jaymzmnrd/myoelectric-prosthetic-hand/hardware/design/Parts flat lay on cutting mat.jpg

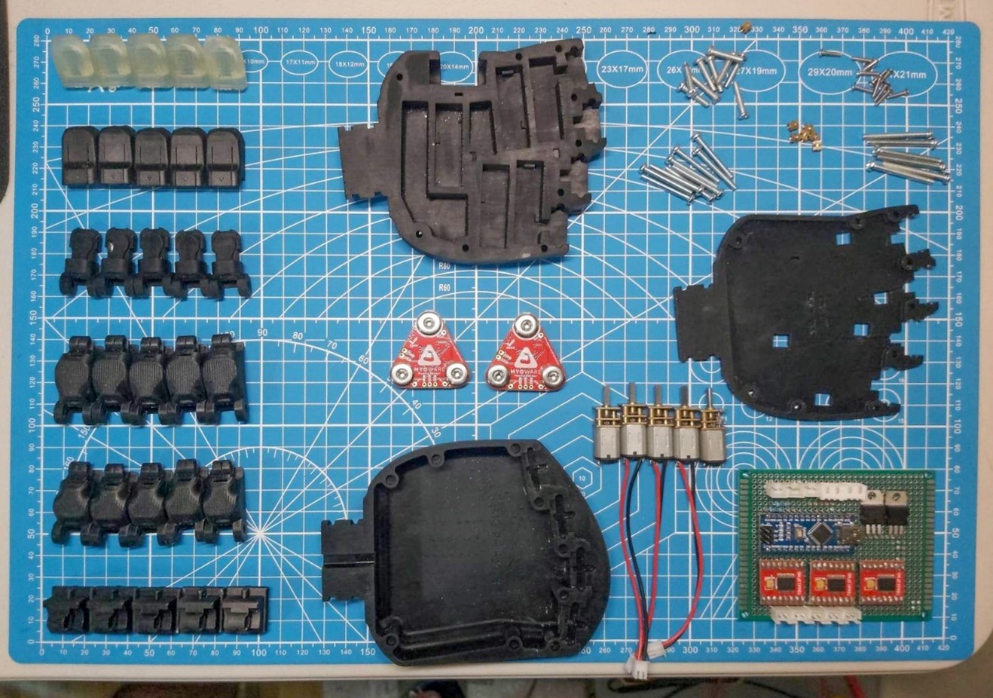
hardware/design/Parts flat lay on cutting mat.jpg
