jaymzmnrd/myoelectric-prosthetic-hand/hardware/design/Post processed sleeve with velcro strap attached.jpg

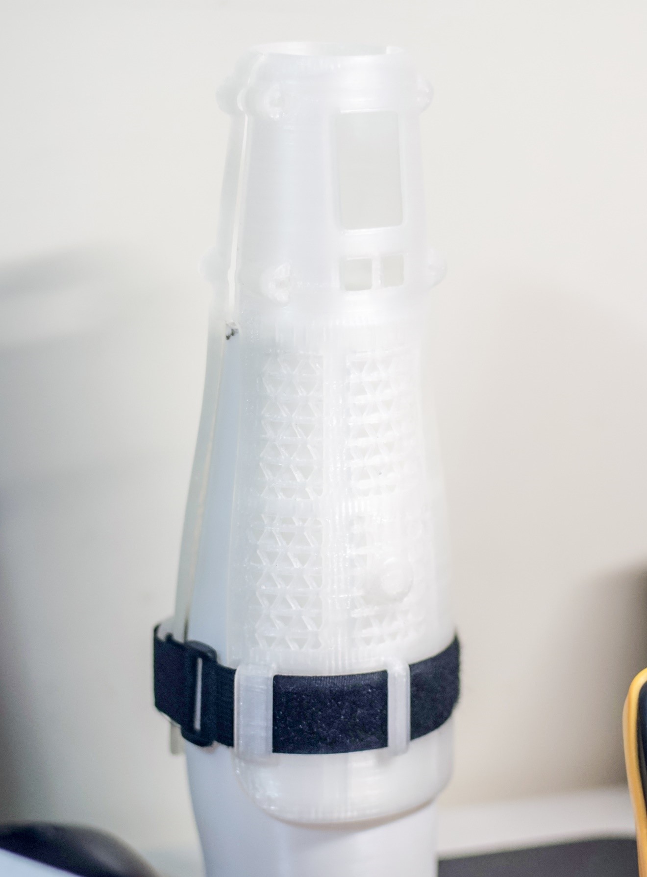
hardware/design/Post processed sleeve with velcro strap attached.jpg
