jaymzmnrd/myoelectric-prosthetic-hand/docs/README.md

## Cost

One of the project targets was to create an affordable prosthetic hand for amputees. The total cost of the device is 24,513 pesos. The prosthetic hand uses two (2) MyoWare sensors which is 21.21% of the total cost.

## Schematic Diagram

**Schematic diagram of the device**

overall-schematic

**Wiring diagram of power supply**

power-supply-diagram

## Software Specifications

- Visual Studio Code (Python)
- Arduino IDE 
- Fritzing
- Onshape

## Hardware Specifications
- MyoWare 2.0 Muscle Sensor
- Arduino Nano
- Sparkfun Motor Drivers
- Force-Sensitive Resistor
- DC Motor
- Vibration Motor
- PKCell 21700 Battery 3.7v
- Kevlar String
- Voltage Regulator 
- Resistor
- NPN Transistor
- Battery Capacity Indicator
- Charging Module
- Push Button Switch
- Step-Up Module
- Microswitch Pushbutton
- USB Type-C Female Connector
- Brass Rod
- Torsion Springs
- Round Head Screw
