jaymzmnrd/myoelectric-prosthetic-hand/hardware/circuit-schematics/overall-schematic.png

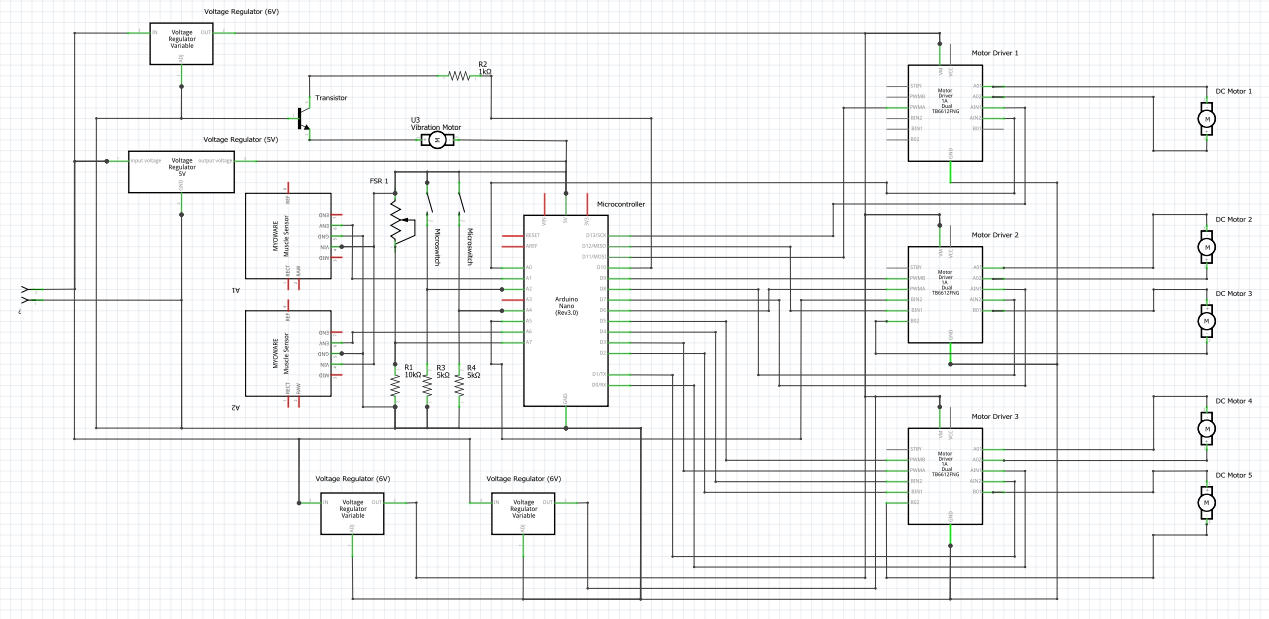
hardware/circuit-schematics/overall-schematic.png
