jaymzmnrd/myoelectric-prosthetic-hand/hardware/circuit-schematics/power-supply-diagram.PNG

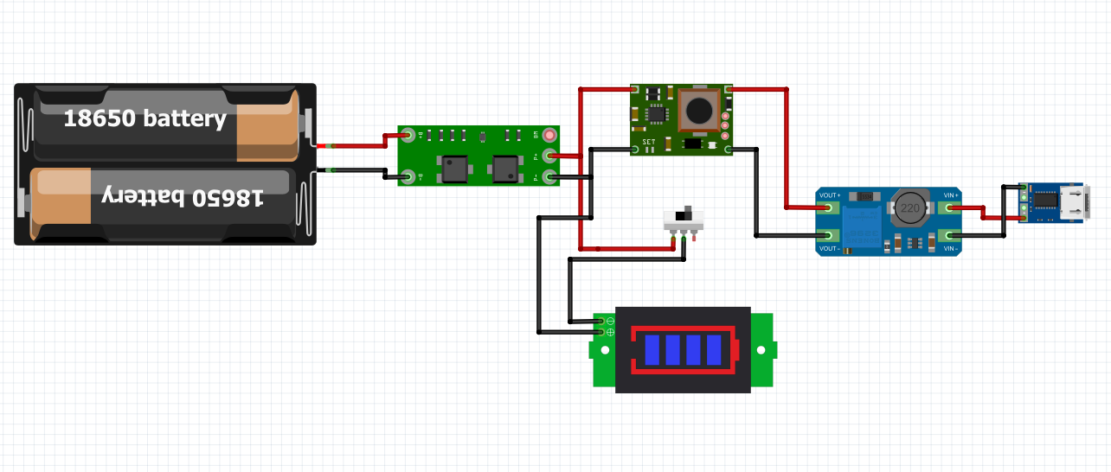
hardware/circuit-schematics/power-supply-diagram.PNG
