jaymzmnrd/myoelectric-prosthetic-hand/hardware/design/Exploded view of the device.png

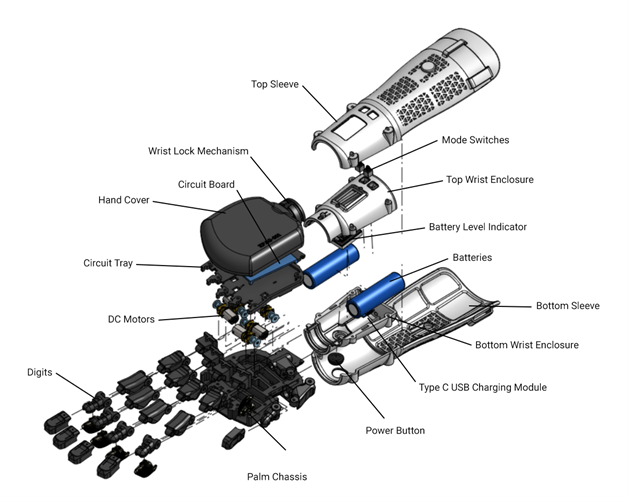
hardware/design/Exploded view of the device.png
