jaymzmnrd/myoelectric-prosthetic-hand/hardware/design/Front and back view.png

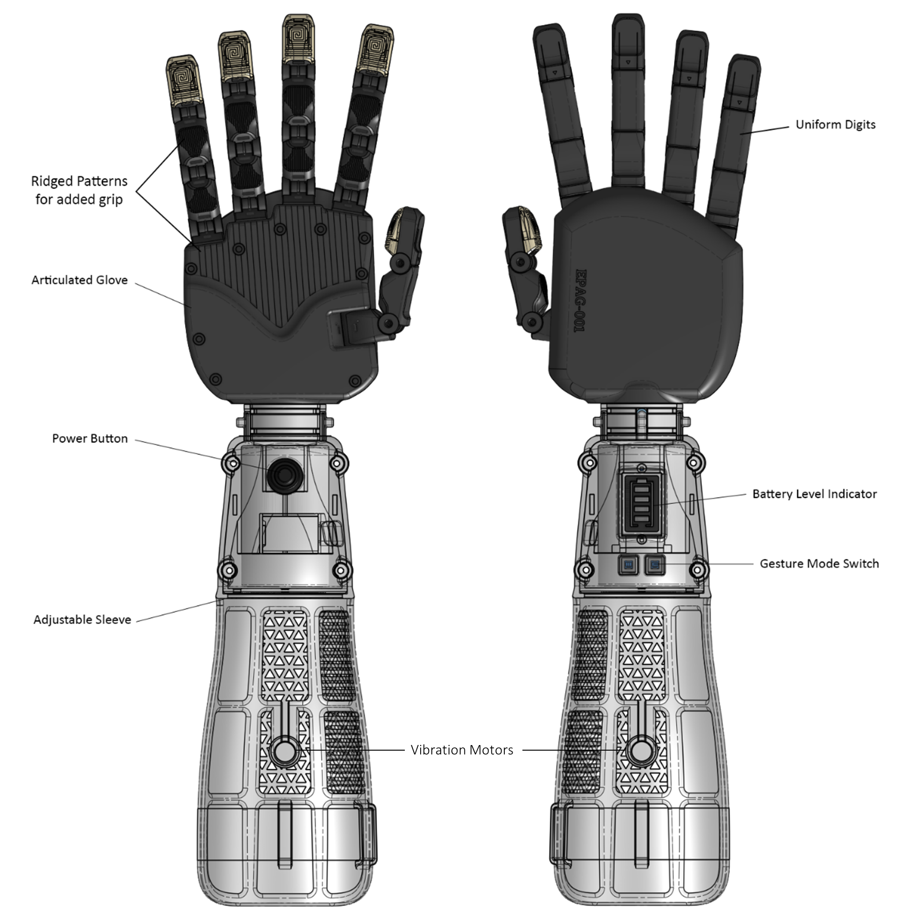
hardware/design/Front and back view.png
