jaymzmnrd/myoelectric-prosthetic-hand/hardware/design/Isometric view with phantom tangent lines and fingers articulated.png

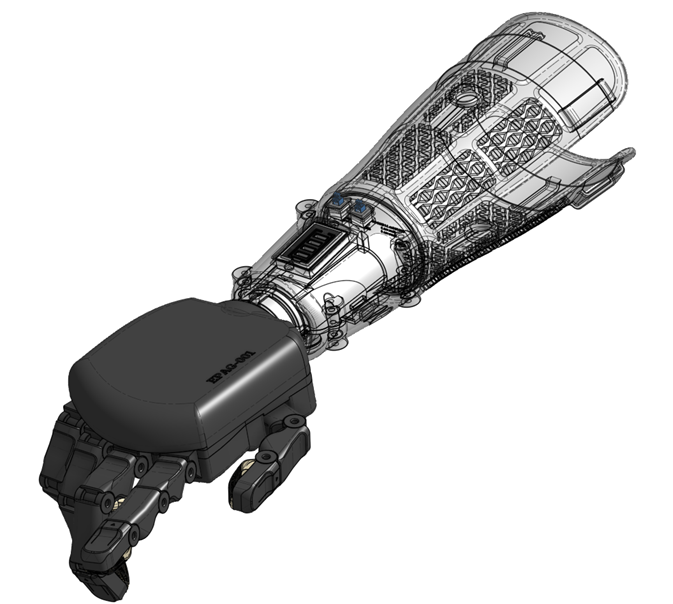
hardware/design/Isometric view with phantom tangent lines and fingers articulated.png
