jaymzmnrd/myoelectric-prosthetic-hand/hardware/design/Semi-open view of the power supply section.png

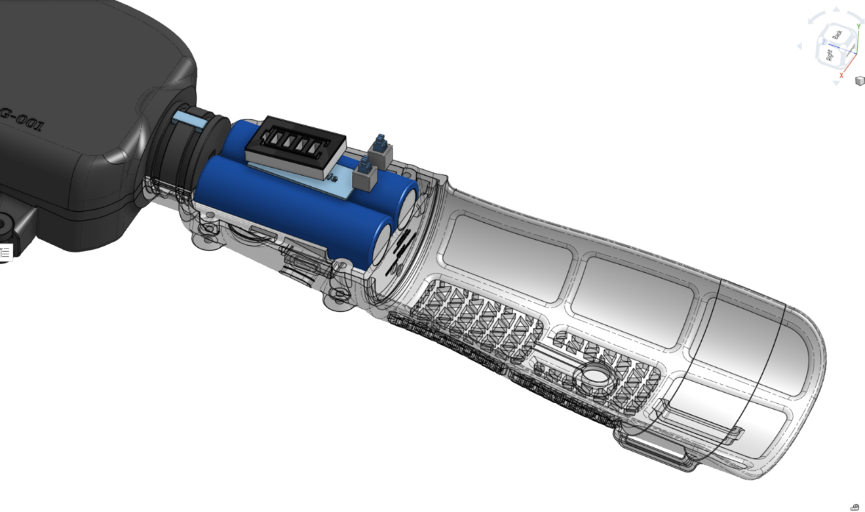
hardware/design/Semi-open view of the power supply section.png
