jaymzmnrd/myoelectric-prosthetic-hand/hardware/design/3D printed parts on the printer build plate.png

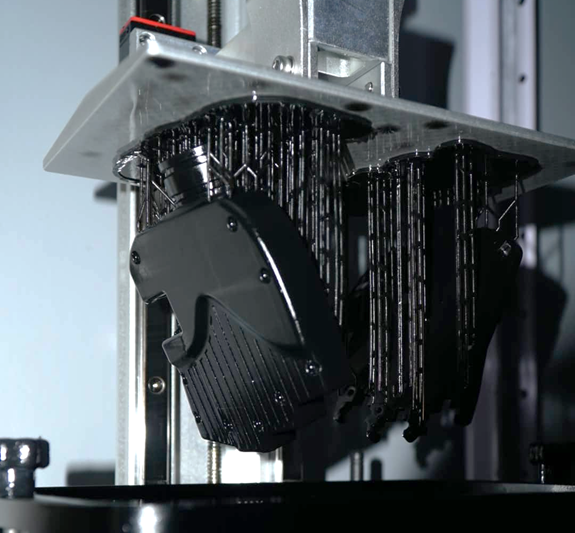
hardware/design/3D printed parts on the printer build plate.png
