jaymzmnrd/myoelectric-prosthetic-hand/hardware/design/Sleeve (forearm) parts.jpg

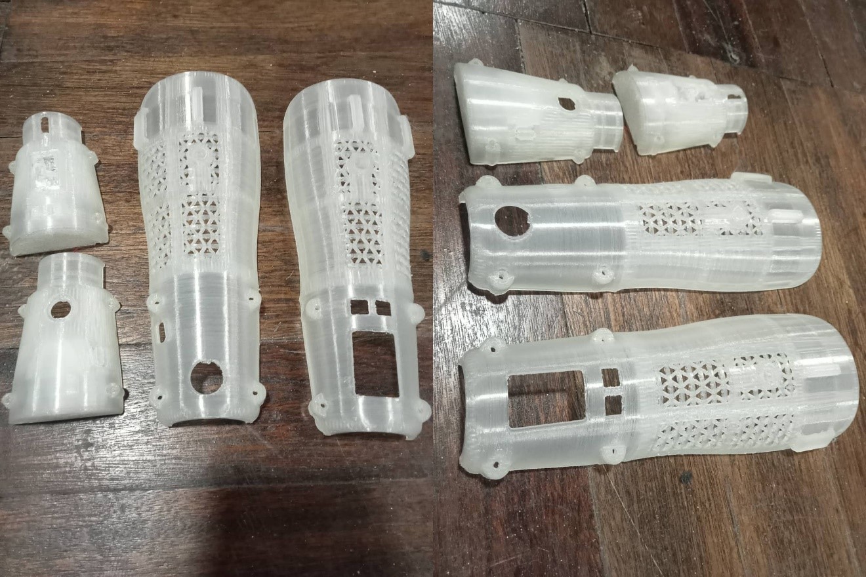
hardware/design/Sleeve (forearm) parts.jpg
