jaymzmnrd/myoelectric-prosthetic-hand/hardware/design/Progressive glove dissassembly view.png

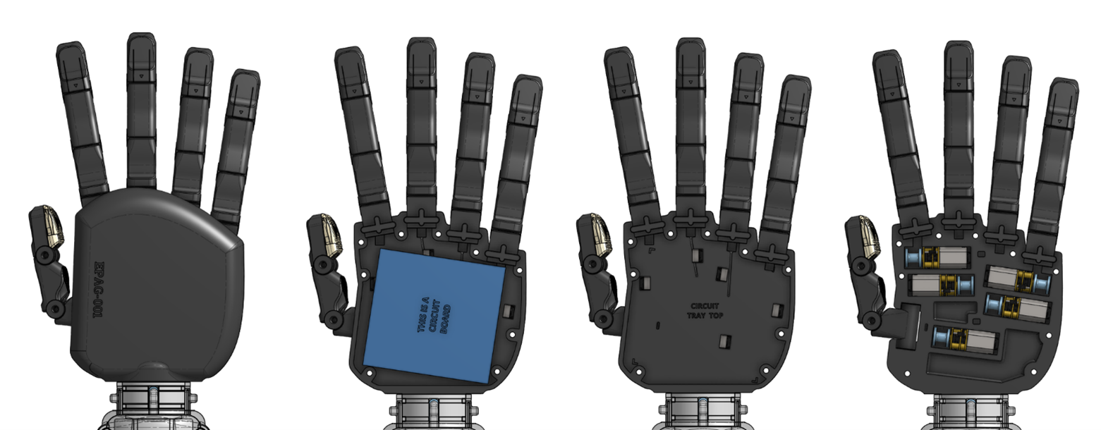
hardware/design/Progressive glove dissassembly view.png
